Varghese-Alen/sheet-metal-pc-case/sheet-parts-bom.csv

ID | quantity | material | thickness_mm | flat_width_mm | flat_height_mm | net_flat_area_mm2 | estimated_unfinished_mass_kg_each | file
S01-S02 | 2 | 5052-H32 aluminium | 1.5 | 410.0 | 521.2263835063059 | 203386.09093679534 | 0.8176120855659174 | DXF/S01-S02.dxf
W01 | 1 | mild steel | 1 | 338.06106156809756 | 1238.0502778222472 | 341880.84918131074 | 2.683764666073289 | DXF/W01.dxf
I01 | 1 | aluminium | 1 | 46.0 | 168.0 | 6434.271776450067 | 0.01724384836088618 | DXF/I01.dxf
C01 | 1 | mild steel | 1 | 20.0 | 38.23053078404875 | 746.4522101432261 | 0.005859649849624325 | DXF/C01.dxf
C02 | 1 | mild steel | 1 | 20.0 | 38.23053078404875 | 746.4522101432261 | 0.005859649849624325 | DXF/C02.dxf
C03 | 1 | mild steel | 1 | 20.0 | 38.23053078404875 | 746.4522101432261 | 0.005859649849624325 | DXF/C03.dxf
C04 | 1 | mild steel | 1 | 20.0 | 38.23053078404875 | 746.4522101432261 | 0.005859649849624325 | DXF/C04.dxf
T01 | 1 | mild steel | 1 | 16.0 | 29.730530784048753 | 457.530087007031 | 0.0035916111830051932 | DXF/T01.dxf
T02 | 1 | mild steel | 1 | 16.0 | 29.730530784048753 | 457.530087007031 | 0.0035916111830051932 | DXF/T02.dxf
M02 | 1 | mild steel | 1 | 151.0 | 42.49823078404876 | 2224.6642928712126 | 0.017463614699039016 | DXF/M02.dxf
M03 | 1 | mild steel | 3 | 14.0 | 151.0 | 2069.8213533088915 | 0.048744292870424394 | DXF/M03.dxf
F01 | 1 | mild steel | 1 | 120.0 | 176.23053078404877 | 8553.888037312909 | 0.06714802109290632 | DXF/F01.dxf
I02 | 1 | mild steel | 1 | 180.0 | 115.4610615680975 | 14895.967197879687 | 0.11693334250335553 | DXF/I02.dxf
G01 | 1 | mild steel | 3 | 24.0 | 182.09734457253856 | 3843.2190185057316 | 0.09050780788580998 | DXF/G01.dxf
G02 | 1 | mild steel | 3 | 20.0 | 109.09734457253856 | 2150.1382658331745 | 0.05063575616037126 | DXF/G02.dxf
M01 | 1 | mild steel | 1 | 277.0 | 479.46106156809753 | 119469.14605990761 | 0.9378327965702746 | DXF/M01.dxf
R01 | 1 | mild steel | 1 | 298.0 | 431.0 | 91230.9630298792 | 0.7161630597845516 | DXF/R01.dxf
I03 | 1 | mild steel | 1 | 68.00000000000001 | 88.0 | 5041.239436842723 | 0.03957372957921537 | DXF/I03.dxf
