Varghese-Alen/sheet-metal-pc-case/CAD/Sheet Metal PC Case Assembly.step

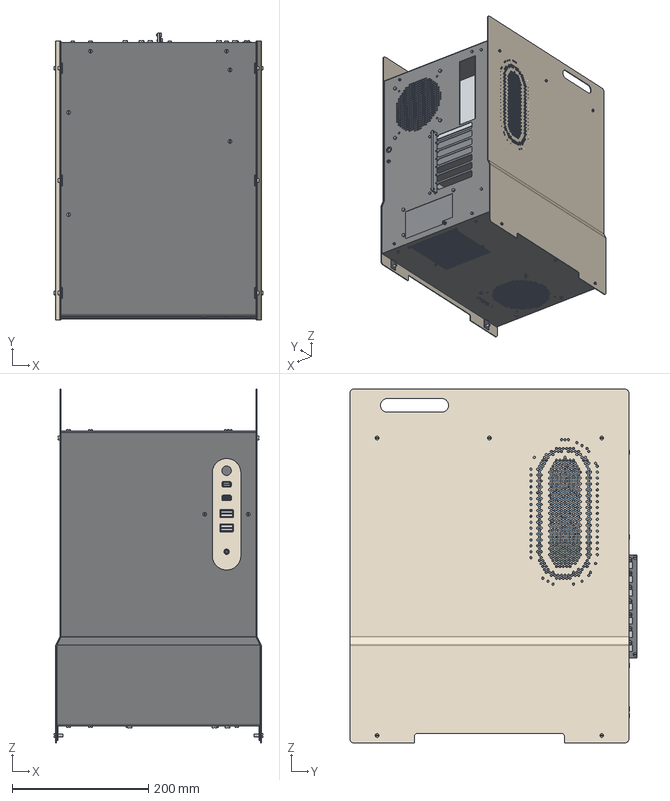
[picture p7: CAD file, 2026-10-19]
CAD/Sheet Metal PC Case Assembly.step
306.8 x 422.0 x 520.0 mm
S01 Sand sled right / radiused joggle
S02 Sand sled left / mirrored fold hand
W01 Single charcoal wrap / four main bends and ten downward ears
R01 Rear hardware interface / fastened to wrap and tray
I01 Full 2C / 2A / stereo audio / power fascia
M02 1mm PCI formed interface with clearance holes
M01 Removable motherboard tray / radiused channel
ATX PCB envelope 304.8 x243.84
CPU cooler target 170 high with125x112 plan
GPU target 340 long x150 projection x65 thick
ATX PSU target180deep x150wide x86high
2.5 inch SSD reference 7 mm
Bottom140 intake envelope
Rear140 exhaust envelope
Optional120 fan reference / X115..140
ATX 9.525 female / M3x5 male standoff A
ATX 9.525 female / M3x5 male standoff C
ATX 9.525 female / M3x5 male standoff F
ATX 9.525 female / M3x5 male standoff G
ATX 9.525 female / M3x5 male standoff H
ATX 9.525 female / M3x5 male standoff J
ATX 9.525 female / M3x5 male standoff K
ATX 9.525 female / M3x5 male standoff L
ATX 9.525 female / M3x5 male standoff M
E-Switch PV0F24011 envelope / Ø14 bezel,18±1mm under-bezel terminal depth
Side removable M3x8
Side captive RRE03-1
Side removable M3x001
Side captive RRE03-001
Side removable M3x002
Side captive RRE03-002
Side removable M3x003
Side captive RRE03-003
Side removable M3x004
Side captive RRE03-004
Side removable M3x005
Side captive RRE03-005
Side removable M3x006
Side captive RRE03-006
Side removable M3x007
Side captive RRE03-007
Side removable M3x008
Side captive RRE03-008
Side removable M3x009
Side captive RRE03-009
Side captive conductive shim0.2
Side captive conductive shim0.001
Side captive conductive shim0.002
Side captive conductive shim0.003
Side captive conductive shim0.004
Side captive conductive shim0.005
Side captive conductive shim0.006
Side captive conductive shim0.007
Side captive conductive shim0.008
Side captive conductive shim0.009
Fascia captive perimeter gasket0.5
Standoff locknut A
PCB M3x6 A
Standoff locknut C
PCB M3x6 C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
