Varghese-Alen/sheet-metal-pc-case/DXF/Alternatives/I00-fully-blank-option.dxf

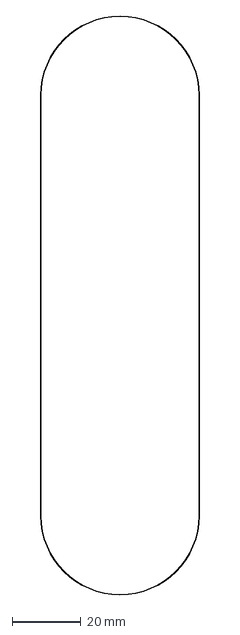
[picture p8: CAD file, 2026-10-19]
DXF/Alternatives/I00-fully-blank-option.dxf
46.0 x 168.0 mm
