Varghese-Alen/sheet-metal-pc-case/DXF/Alternatives/I01-power-only.dxf

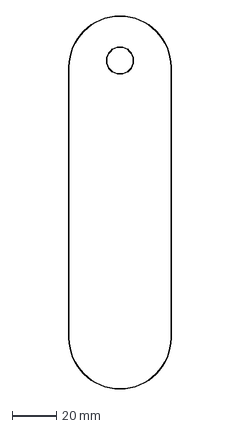
[picture p9: CAD file, 2026-10-19]
DXF/Alternatives/I01-power-only.dxf
46.0 x 168.0 mm
