Varghese-Alen/sheet-metal-pc-case/DXF/Ancillary-cuts/GSK01-fascia-gasket.dxf

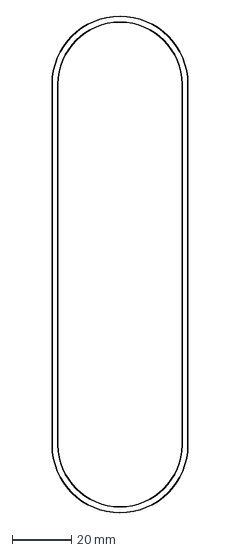
[picture p10: CAD file, 2026-10-19]
DXF/Ancillary-cuts/GSK01-fascia-gasket.dxf
46.0 x 168.0 mm
