Varghese-Alen/sheet-metal-pc-case/DXF/Process-coupons/QC01-steel-R1.dxf

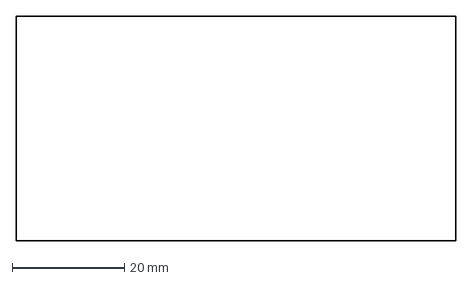
[picture p11: CAD file, 2026-10-19]
DXF/Process-coupons/QC01-steel-R1.dxf
78.2 x 40.0 mm
