Varghese-Alen/sheet-metal-pc-case/DXF/T02.dxf

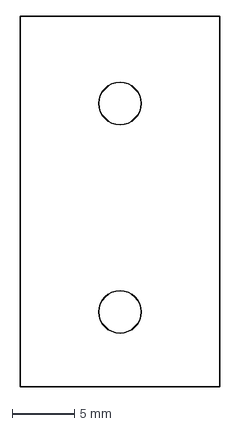
[picture p12: CAD file, 2026-10-19]
DXF/T02.dxf
16.0 x 29.7 mm
