Varghese-Alen/sheet-metal-pc-case/Source/Approved-design.FCStd

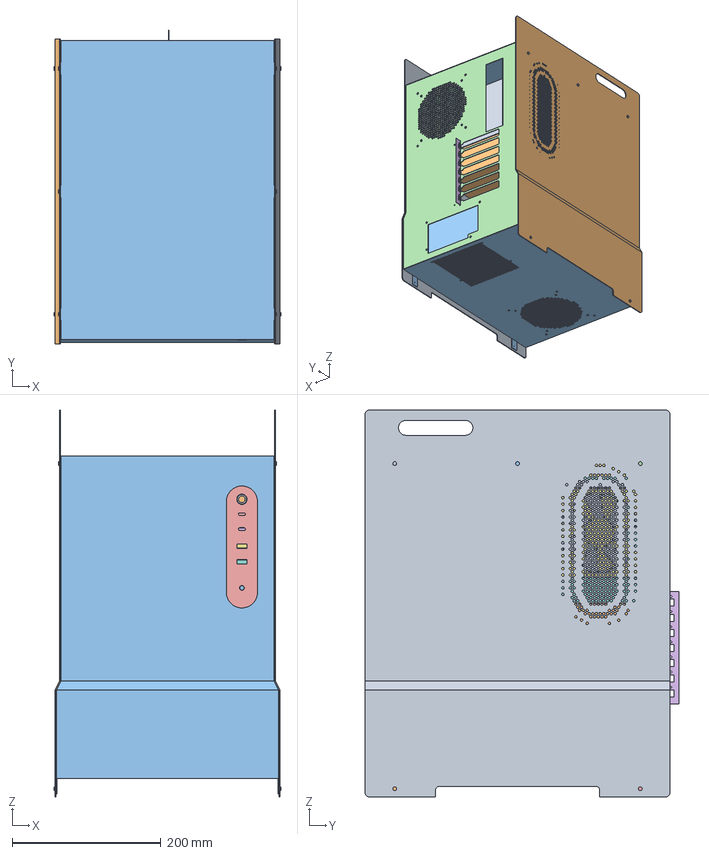
[picture p13: CAD file, 2026-10-19]
Source/Approved-design.FCStd
304.6 x 422.0 x 520.0 mm
S01 Sand sled plate, right
S02 Sand sled plate, left
W01 Charcoal top front bottom wrap
R01 Rear standard hardware interface
I01 Sand vertical capsule I O fascia
M02 Standard card retention rail, prototype
M01 Universal ATX micro ATX Mini ITX tray
ATX PCB envelope 304.8 x243.84
CPU cooler target 170 high with125x112 plan
GPU target 340 long x150 projection x65 thick
ATX PSU target180deep x150wide x86high
2.5 inch SSD reference 7 mm
Bottom140 intake envelope
Rear140 exhaust envelope
Optional side120 space reservation
PSU support8
PSU support001
PSU support002
PSU support003
ATX standoff A
ATX standoff C
ATX standoff F
ATX standoff G
ATX standoff H
ATX standoff J
ATX standoff K
ATX standoff L
ATX standoff M
USB C fascia illustration
USB C fascia illustration001
USB A fascia illustration
USB A fascia illustration001
Powerbutton reference appearance
Powerbutton dark inset
Audio jack illustration
Sledplate sand screw
Sledplate sand screw001
Sledplate sand screw002
Sledplate sand screw003
Sledplate sand screw004
Sledplate sand screw005
Sledplate sand screw006
Sledplate sand screw007
Sledplate sand screw008
Sledplate sand screw009
