Varghese-Alen/sheet-metal-pc-case/CAD/Sheet Metal PC Case Sheet Parts.step

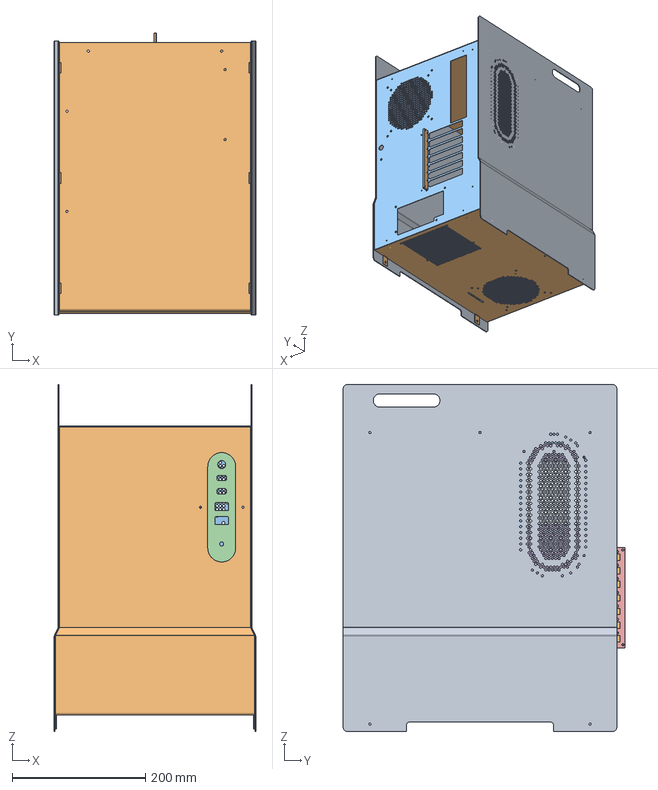
[picture p14: CAD file, 2026-10-19]
CAD/Sheet Metal PC Case Sheet Parts.step
302.0 x 422.0 x 520.0 mm
