Varghese-Alen/sheet-metal-pc-case/DXF/Ancillary-cuts/SH01-side-head-shim.dxf

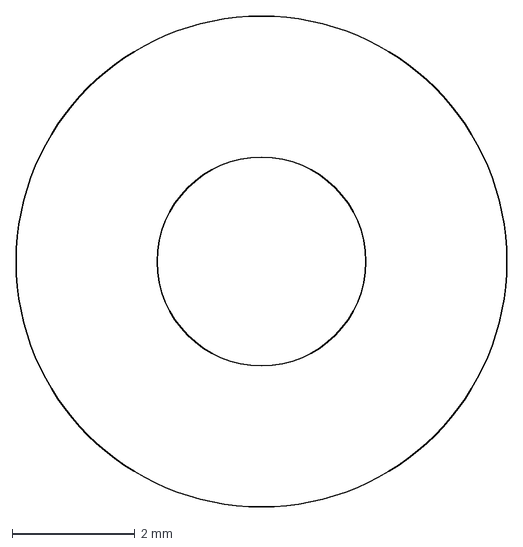
[picture p15: CAD file, 2026-10-19]
DXF/Ancillary-cuts/SH01-side-head-shim.dxf
8.00 x 8.00 mm
