Varghese-Alen/sheet-metal-pc-case/DXF/I03.dxf

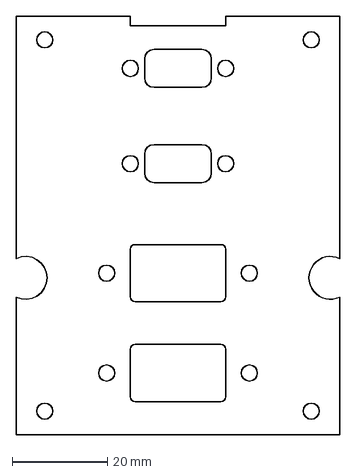
[picture p16: CAD file, 2026-10-19]
DXF/I03.dxf
68.0 x 88.0 mm
