Varghese-Alen/sheet-metal-pc-case/DXF/Process-coupons/QC02-side-R2p25.dxf

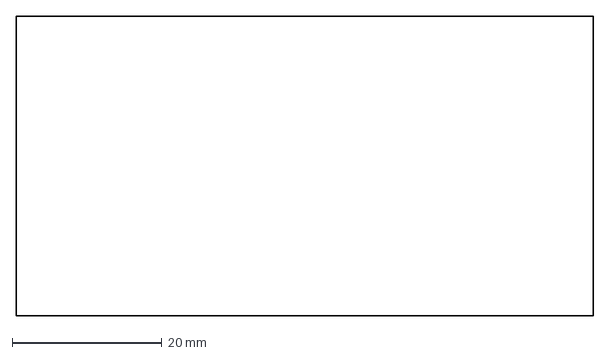
[picture p17: CAD file, 2026-10-19]
DXF/Process-coupons/QC02-side-R2p25.dxf
77.0 x 40.0 mm
