Varghese-Alen/sheet-metal-pc-case/CAD/Sheet Metal PC Case Flat Patterns.FCStd

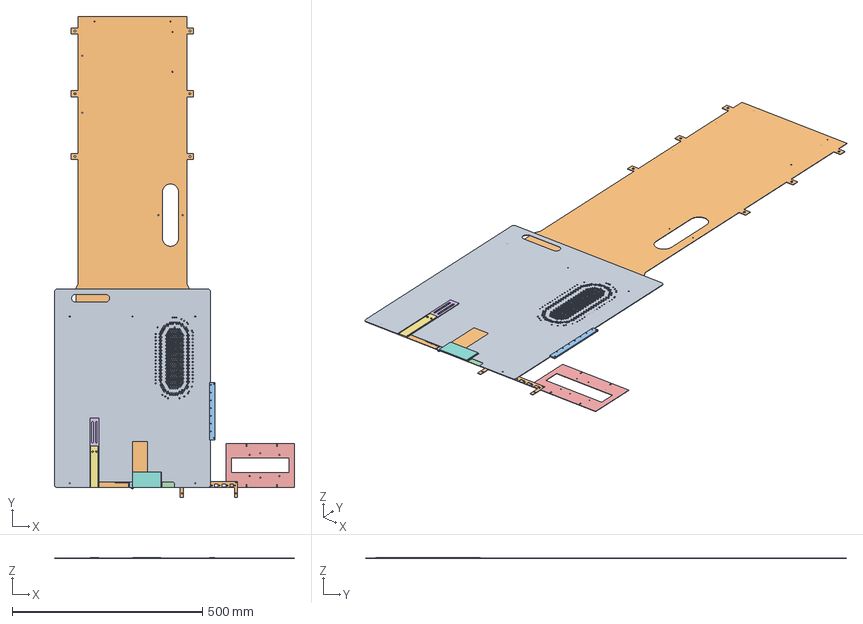
[picture p18: CAD file, 2026-10-19]
CAD/Sheet Metal PC Case Flat Patterns.FCStd
631.0 x 1264.5 x 3.00 mm
S01-S02
W01
I01
C01
C02
C03
C04
T01
T02
M02
M03
F01
I02
G01
G02
M01
R01
I03
I00-fully-blank-option
I01-power-only
I01-C1
QC01-steel-R1
QC02-side-R2p25
QC03-support-R3
QC04-rivnut-power
QC05-side-joggle
QC06-wrap-joggle
GSK01-fascia-gasket
SH01-side-head-shim
