Varghese-Alen/sheet-metal-pc-case/DXF/Alternatives/I01-C1.dxf

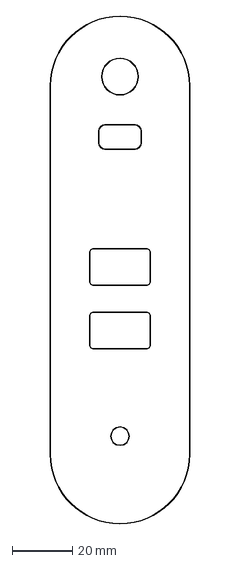
[picture p19: CAD file, 2026-10-19]
DXF/Alternatives/I01-C1.dxf
46.0 x 168.0 mm
