Varghese-Alen/sheet-metal-pc-case/DXF/C04.dxf

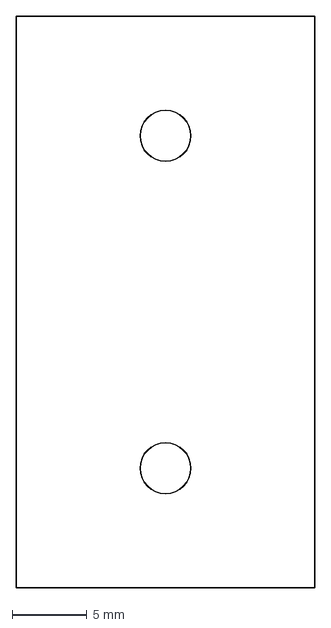
[picture p20: CAD file, 2026-10-19]
DXF/C04.dxf
20.0 x 38.2 mm
