Varghese-Alen/sheet-metal-pc-case/DXF/Process-coupons/QC05-side-joggle.dxf

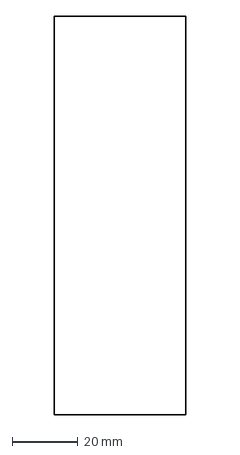
[picture p21: CAD file, 2026-10-19]
DXF/Process-coupons/QC05-side-joggle.dxf
40.0 x 121.2 mm
