Varghese-Alen/sheet-metal-pc-case/DXF/Process-coupons/QC03-support-R3.dxf

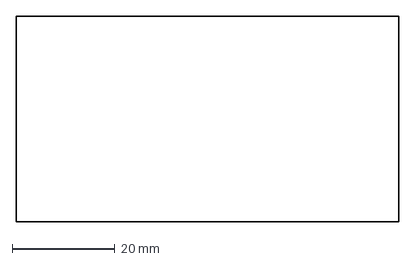
[picture p22: CAD file, 2026-10-19]
DXF/Process-coupons/QC03-support-R3.dxf
74.6 x 40.0 mm
