Varghese-Alen/sheet-metal-pc-case/DXF/S01-S02.dxf

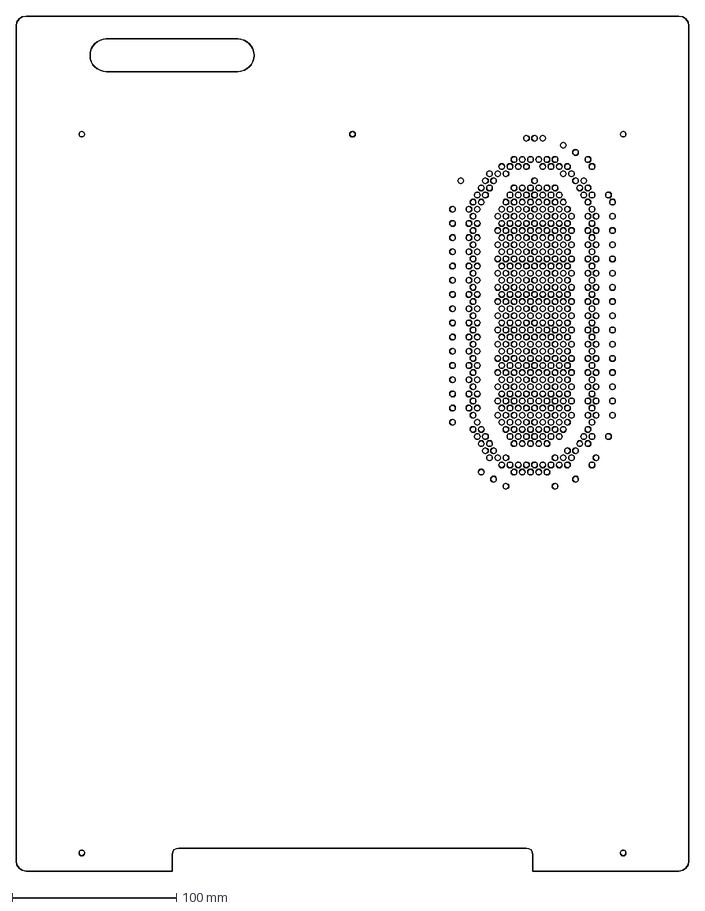
[picture p23: CAD file, 2026-10-19]
DXF/S01-S02.dxf
410.0 x 521.2 mm
