Varghese-Alen/sheet-metal-pc-case/DXF/I01.dxf

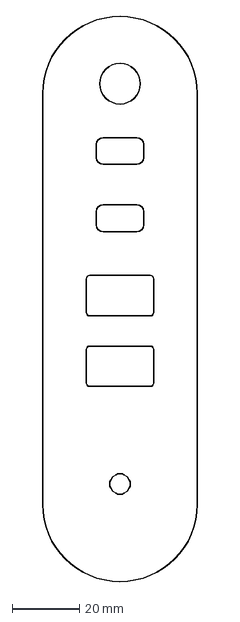
[picture p24: CAD file, 2026-10-19]
DXF/I01.dxf
46.0 x 168.0 mm
