Varghese-Alen/sheet-metal-pc-case/DXF/Process-coupons/QC04-rivnut-power.dxf

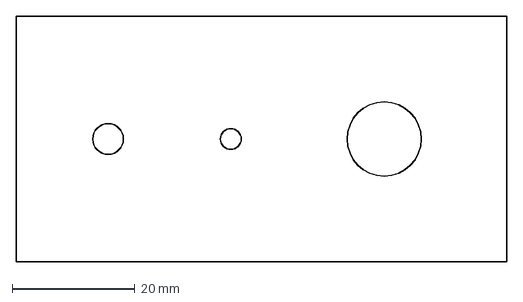
[picture p25: CAD file, 2026-10-19]
DXF/Process-coupons/QC04-rivnut-power.dxf
80.0 x 40.0 mm
