Varghese-Alen/sheet-metal-pc-case/DXF/Process-coupons/QC06-wrap-joggle.dxf

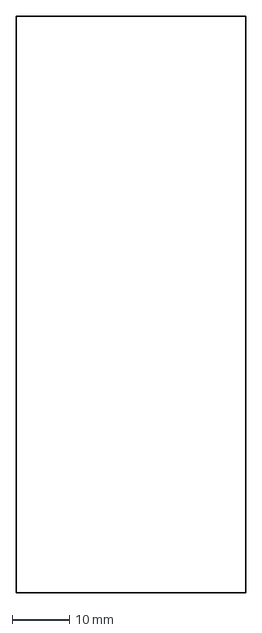
[picture p26: CAD file, 2026-10-19]
DXF/Process-coupons/QC06-wrap-joggle.dxf
40.0 x 100.6 mm
