Varghese-Alen/sheet-metal-pc-case/DXF/I02.dxf

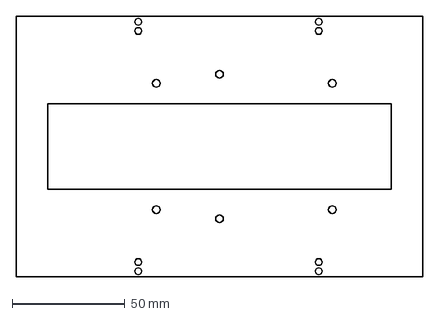
[picture p27: CAD file, 2026-10-19]
DXF/I02.dxf
180.0 x 115.5 mm
