Varghese-Alen/sheet-metal-pc-case/DXF/M02.dxf

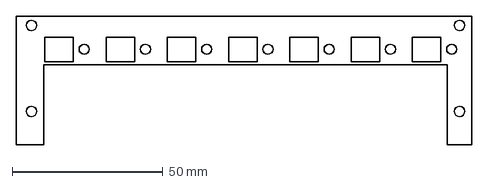
[picture p28: CAD file, 2026-10-19]
DXF/M02.dxf
151.0 x 42.5 mm
