Varghese-Alen/sheet-metal-pc-case/DXF/M03.dxf

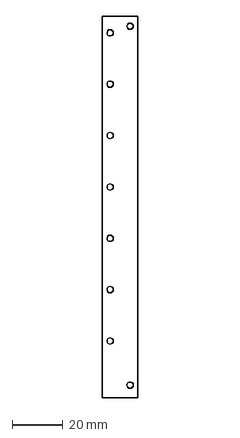
[picture p29: CAD file, 2026-10-19]
DXF/M03.dxf
14.0 x 151.0 mm
