Varghese-Alen/sheet-metal-pc-case/DXF/M01.dxf

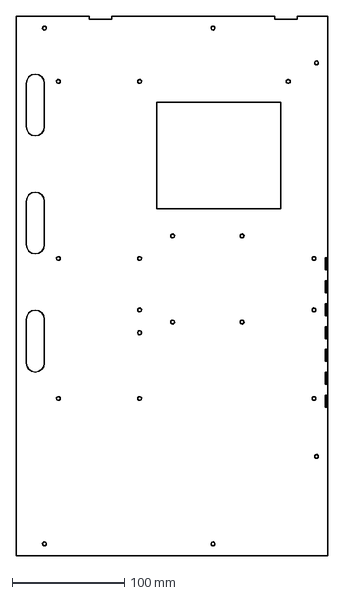
[picture p30: CAD file, 2026-10-19]
DXF/M01.dxf
277.0 x 479.5 mm
