Varghese-Alen/sheet-metal-pc-case/DXF/F01.dxf

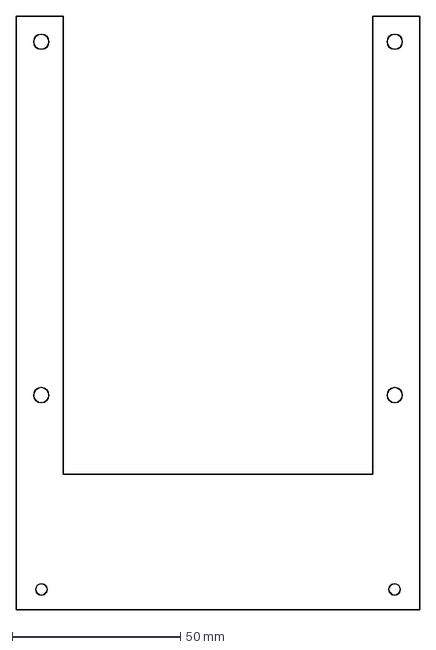
[picture p31: CAD file, 2026-10-19]
DXF/F01.dxf
120.0 x 176.2 mm
