Varghese-Alen/sheet-metal-pc-case/DXF/G02.dxf

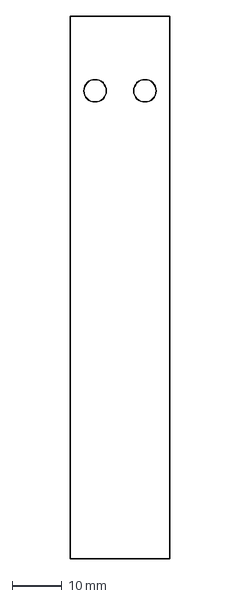
[picture p32: CAD file, 2026-10-19]
DXF/G02.dxf
20.0 x 109.1 mm
