Varghese-Alen/sheet-metal-pc-case/DXF/R01.dxf

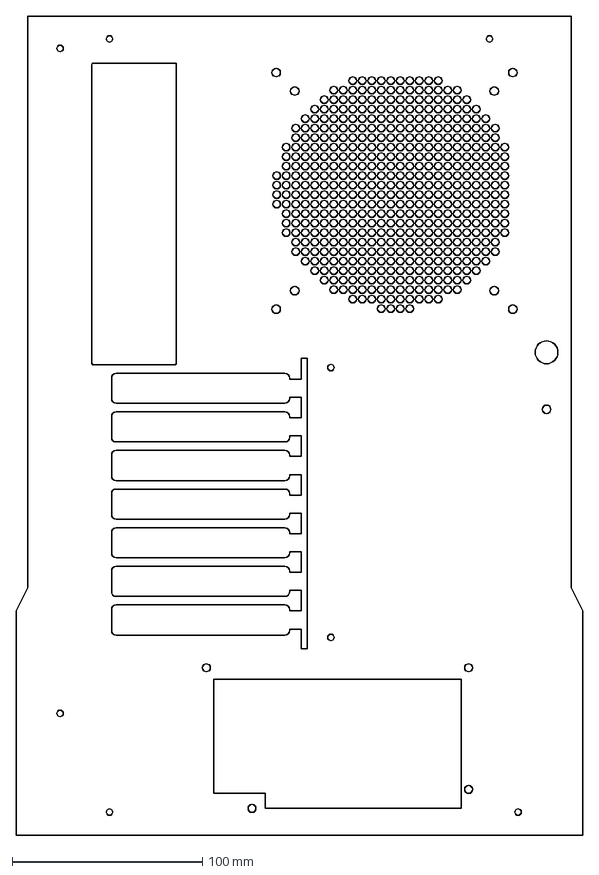
[picture p33: CAD file, 2026-10-19]
DXF/R01.dxf
298.0 x 431.0 mm
