Varghese-Alen/sheet-metal-pc-case/DXF/G01.dxf

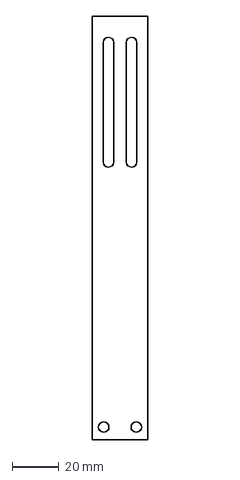
[picture p34: CAD file, 2026-10-19]
DXF/G01.dxf
24.0 x 182.1 mm
