Varghese-Alen/sheet-metal-pc-case/DXF/W01.dxf

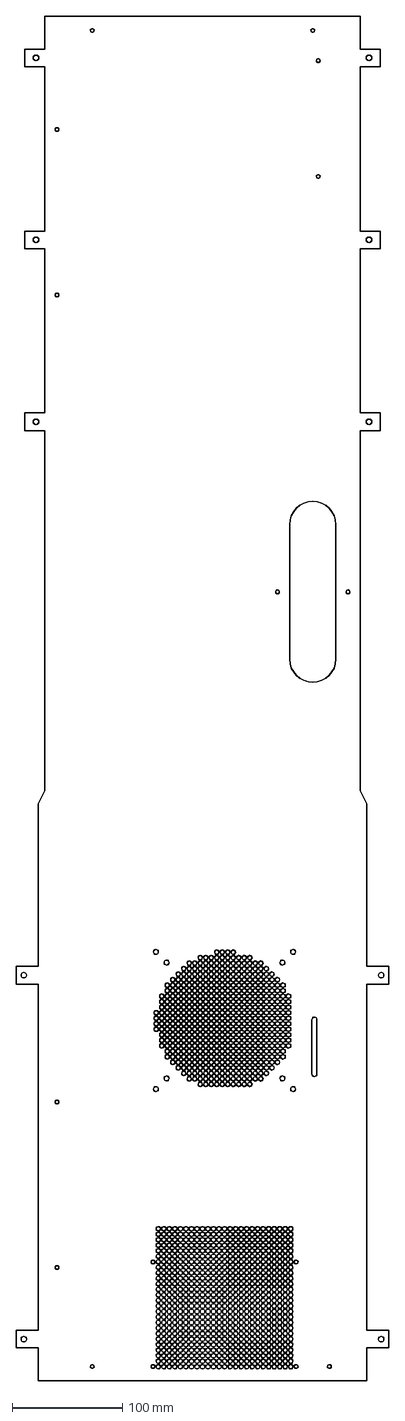
[picture p35: CAD file, 2026-10-19]
DXF/W01.dxf
338.1 x 1238.1 mm
