Varghese-Alen/sheet-metal-pc-case/(list of files, cad)

Other CAD files:
CAD/Sheet Metal PC Case.FCStd
